eduranbegliomini/Entrega-3-Arquitectura-de-Computadores/results/runs.csv

design | tag | status | closes | CLOCK_PERIOD | FP_CORE_UTIL | die_um2 | die_mm2 | cost_usd | core_um2 | stdcell_area_um2 | utilization | stdcells | flip_flops | setup_ws_tt | setup_tns_tt | hold_ws_tt | hold_tns_tt | setup_ws_ss | setup_tns_ss | hold_ws_ss | hold_tns_ss | fmax_est_mhz | route_drc_iter0 | route_drc | magic_drc | klayout_drc | lvs_errors | antenna_nets | max_slew_viol_ss | wirelength_um
rom | T100_U40 | complete | yes | 100 | 40 | 425076 | 0.4251 | 9777 | 394785 | 202986 | 0.514168 | 9032 | 974 | 67.58461004358847 | 0 | 0.3725029279357545 | 0 | 38.052889916165945 | 0 | 0.939814475066 | 0 | 16.14 | 84 | 0 | 0 |  | 0 | 0 | 2532 | 409272
rom | T100_U50 | complete | yes | 100 | 50 | 342812 | 0.3428 | 7885 | 315483 | 200356 | 0.635076 | 8433 | 974 | 70.92811871926 | 0 | 0.3792888332987869 | 0 | 44.50748162664109 | 0 | 0.9550447369931541 | 0 | 18.02 | 84 | 0 | 0 |  | 0 | 0 | 2223 | 374990
rom | T100_U60 | complete | yes | 100 | 60 | 287752 | 0.2878 | 6618 | 263990 | 198556 | 0.752133 | 8083 | 974 | 71.176993424926 | 0 | 0.43378768471752427 | 0 | 44.46781557729545 | 0 | 1.0542003124389725 | 0 | 18.01 | 42 | 0 | 0 |  | 0 | 0 | 2220 | 382491
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
