eduranbegliomini/Entrega-3-Arquitectura-de-Computadores/results/layout/rom_T100_U40_marks.png

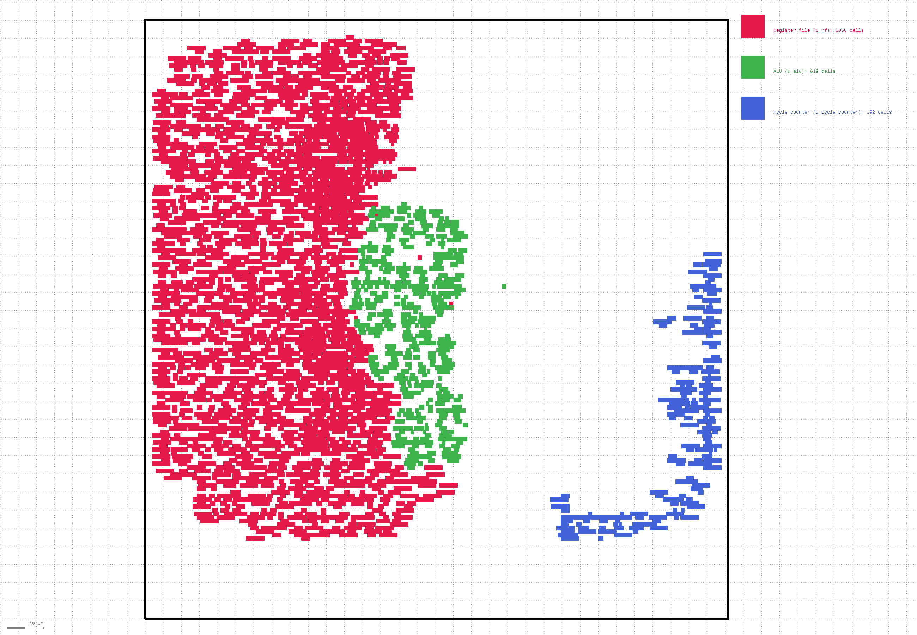
results/layout/rom_T100_U40_marks.png
